talea30/Agrotech/images/linkage curve.jpg

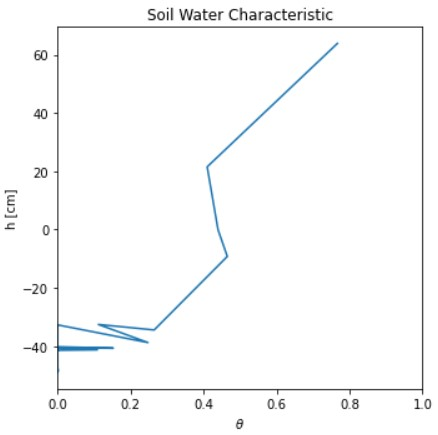
images/linkage curve.jpg
