talea30/Agrotech/images/גרפים.png

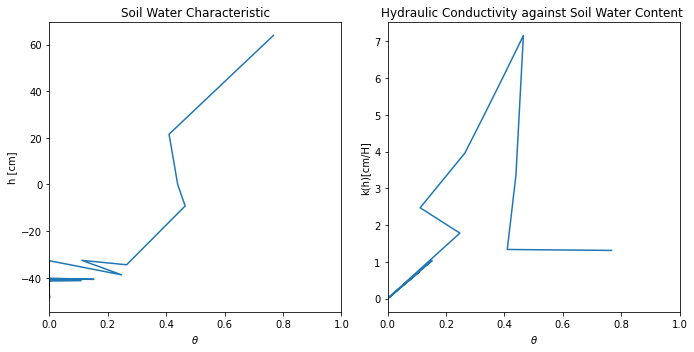
images/גרפים.png
