talea30/Agrotech/(commit log)

2021-07-30 Create דוח פרויקט.rtf
2021-07-30 Update דוח פרויקט.md
2021-07-30 תמונה נוספה
2021-07-30 תמונה במיקום יחסי
2021-08-01 Create מוליכות הידראולית עם השמטת נקודות.jpg
2021-08-01 Create עקום תאחיזה עם השמטת נקודות.jpg
